XuanyouLiu/EITWatch_Hardware/firmware/docs/esp32-pin-map.png

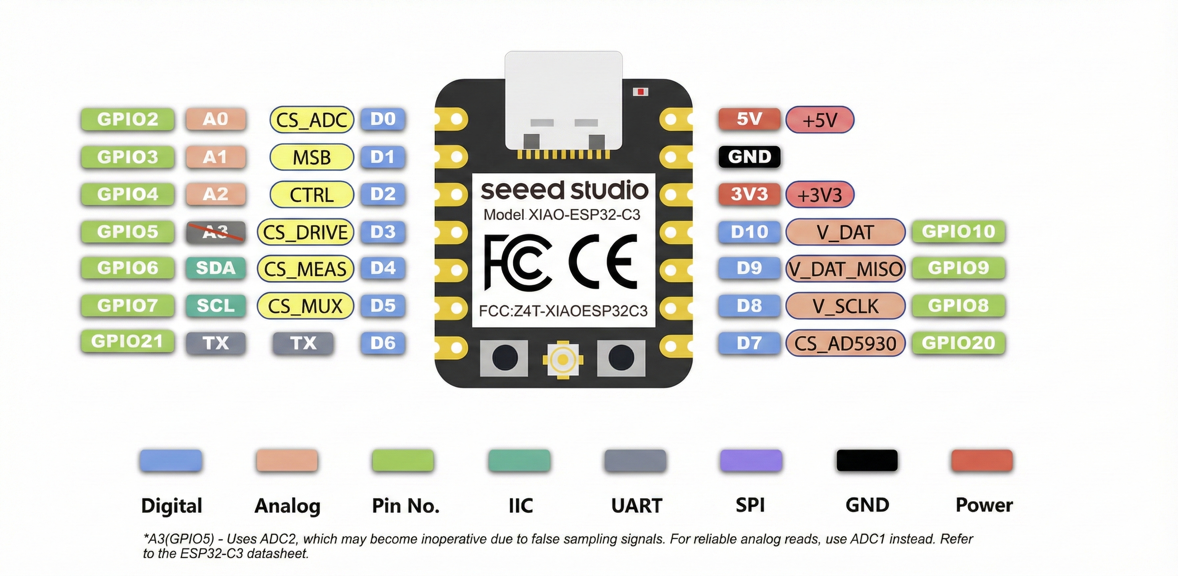
firmware/docs/esp32-pin-map.png
