XuanyouLiu/EITWatch_Hardware/docs/eitwatch.step

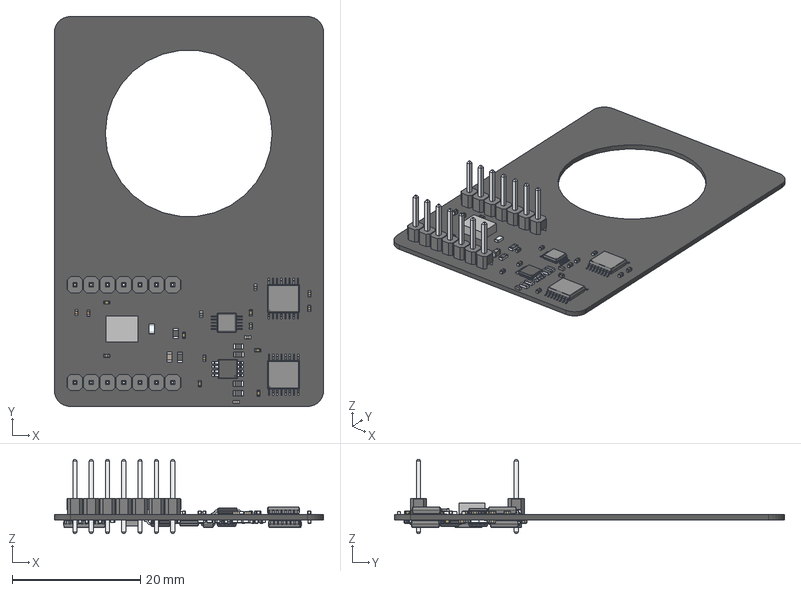
[picture p3: CAD file, 2026-07-22]
docs/eitwatch.step
42.0 x 60.8 x 11.6 mm
Terminals x 2
Electrode x 2
AVX x 2
term1 x 12
term2 x 12
Extruded
DS1021-1x7S61 x 2
PinsArrayLR
BODY-SOT
LEAD-SOT x 5
LEAD-DUMMY
Pin1Body x 14
Pin2Body x 14
CeramicBody x 16
CoatingBody x 14
Pins
Pin1 x 2
Pin2 x 2
