XuanyouLiu/EITWatch_Hardware/docs/schematic.pdf

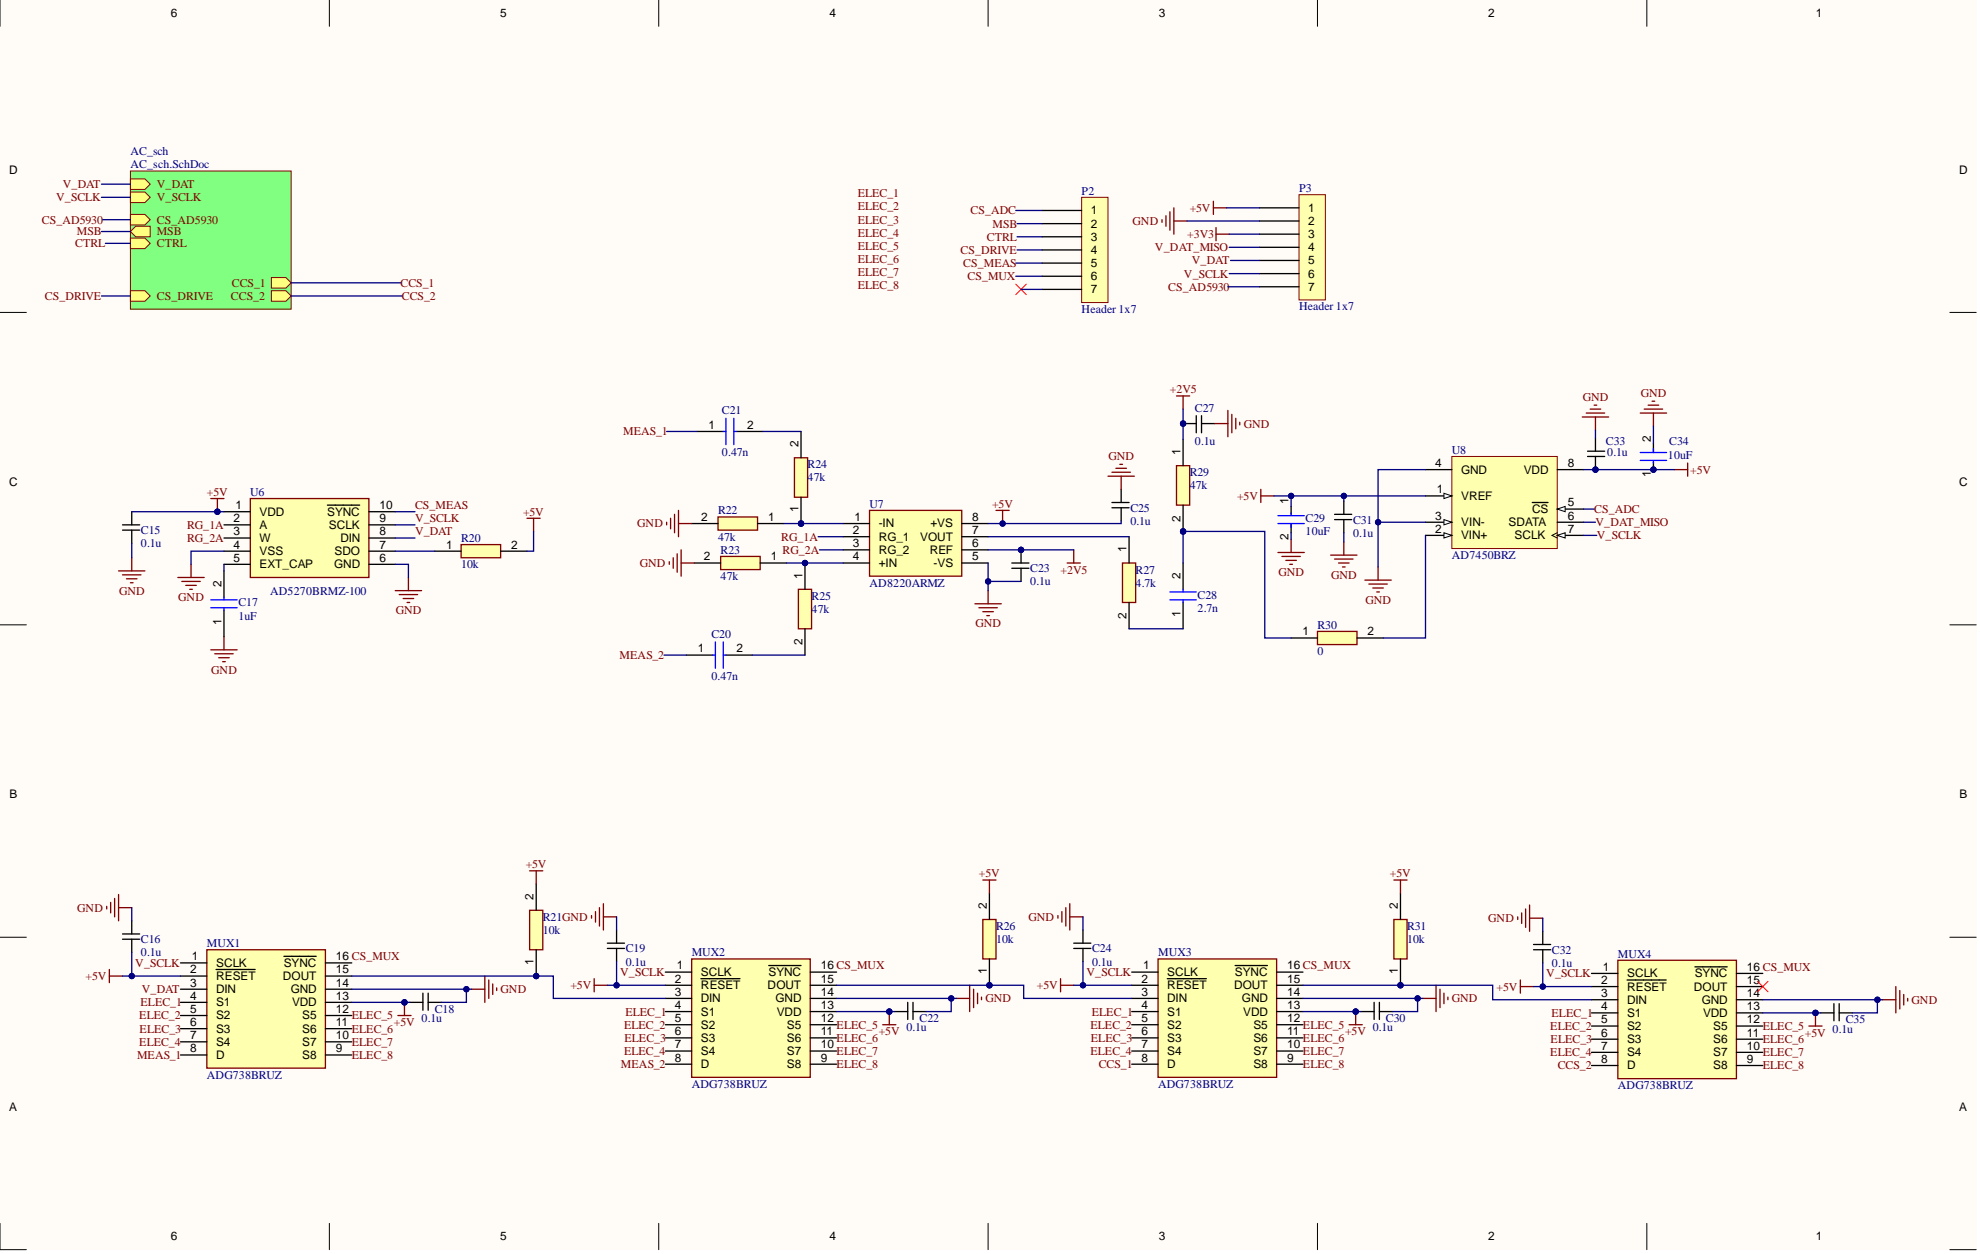
[picture p4: page 1]

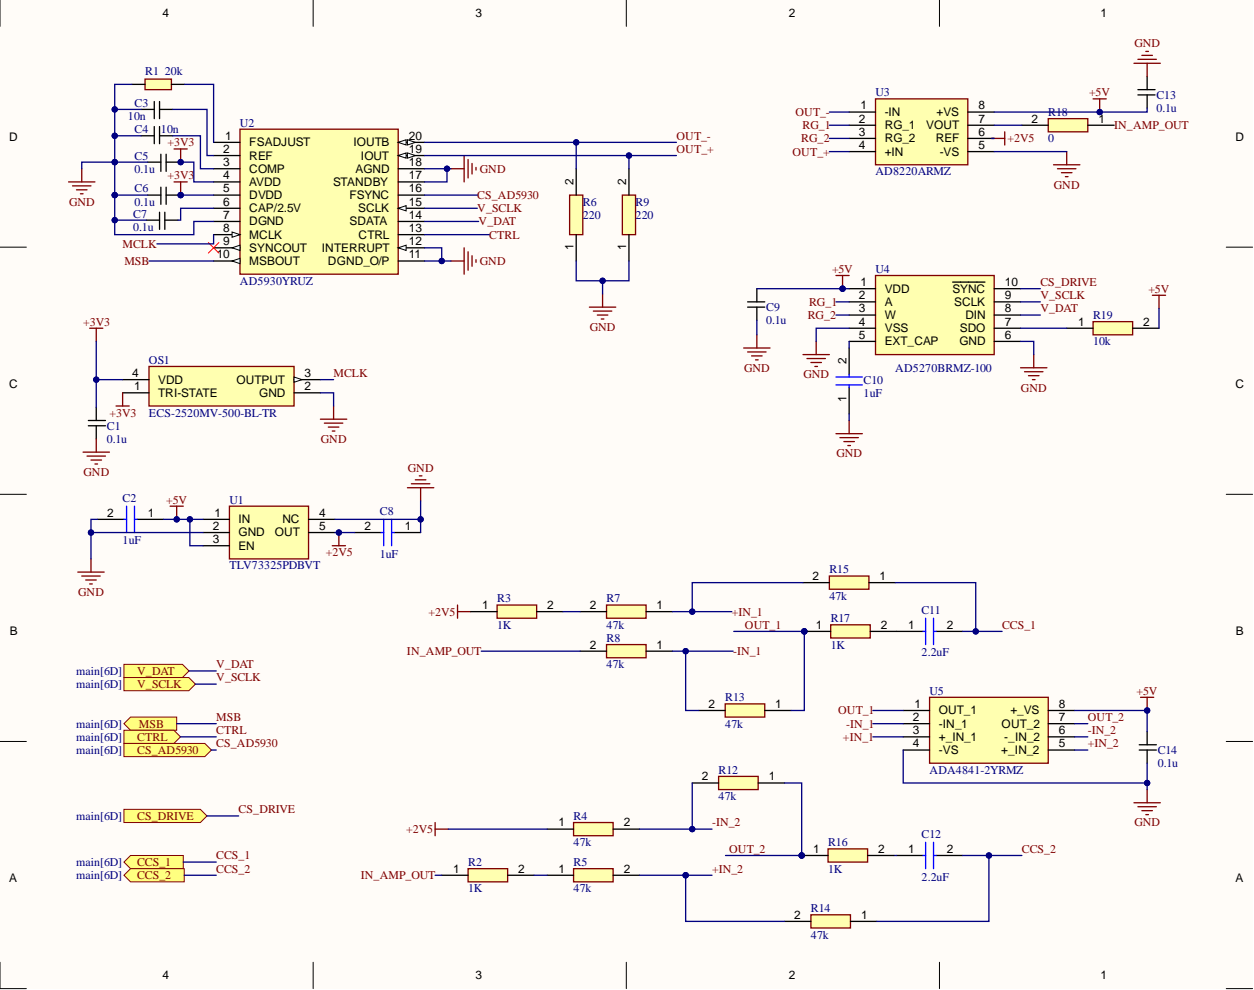
[picture p5: page 2]

COMP 3

GND 2 | 2 | 1
EN 3
