XuanyouLiu/EITWatch_Hardware/(list of files, drawings)

Other design files:
altium/AC_sch.SchDoc
altium/BioWatch.PrjPcb
altium/EITWatch.PrjPcb
altium/Headers.PcbLib
altium/Headers.SchLib
altium/main.PcbDoc
altium/main.SchDoc
altium/PcbLib_AC.PcbLib
altium/Schlib_AC.SchLib
