XuanyouLiu/EITWatch_Hardware/(commit log)

2026-07-22 Initial release of EITWatch open hardware and firmware.
    Publish Altium sources, Gerbers, BOM, docs, and ESP-IDF firmware for the UIST 2026 planar wrist-EIT prototype.
2026-07-22 Update Altium project, Gerbers, BOM, and docs from revised export.
    Rename the project file to EITWatch.PrjPcb and refresh fabrication outputs to match the latest board revision.
2026-07-22 Retarget firmware and docs from XIAO ESP32-C3 to ESP32-S3.
    Remap board pins to S3 GPIO numbers for the same XIAO pads, drop the C3 sdkconfig, and align README build steps with esp32s3.
2026-07-27 Fix firmware build: remove conflicting meas_task extern and unused esp-dsp dependency.
    The measurement task handle is only used inside main.c, where it is
    defined static; the extern declarations in calibration.h and
    measurement.h made that definition a compile error. No code uses
    esp-dsp, so drop it from the middleware component requirements,
    manifest, and README.
2026-07-27 Document relation of released firmware to the paper's Wi-Fi and on-device inference variants.
    The release is the minimal acquisition build (USB Serial JTAG output).
    Note in the firmware README that the paper's Wi-Fi streaming and
    dual-core inference pipeline are straightforward extensions of this
    codebase, so readers do not mistake their absence for a mismatch with
    the paper.
